agusc4/Realidad-virtual-2022/Codigos/Python/3.jpg

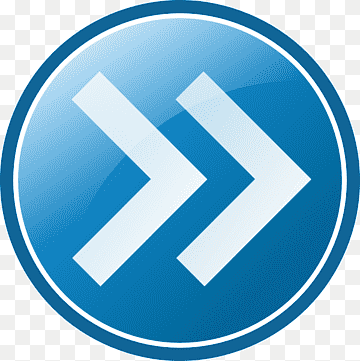
Codigos/Python/3.jpg
