agusc4/Realidad-virtual-2022/README.md

# Realidad-virtual-2022-

Aquí se encuentra el [trabajo final]( https://github.com/agusc4/Realidad-virtual-2022/blob/main/INFORME%20FINAL%20RV.pdf) presentado en la catedra de Realidad Virtual. En el cual se desarrolló un pequeño vehículo diferencial impreso en 3d el cual era controlado a distancia mediante gestos de manos. 

Ademas del informe se encuentran disponibles los [codigos](https://github.com/agusc4/Realidad-virtual-2022/tree/main/Codigos) elavorados en python para el procesamiento de imagenes y asignacion de consignas y en ArduinoID para transmisor, receptor y control de motores.
