agusc4/Realidad-virtual-2022/Codigos/Python/ArUco.pdf

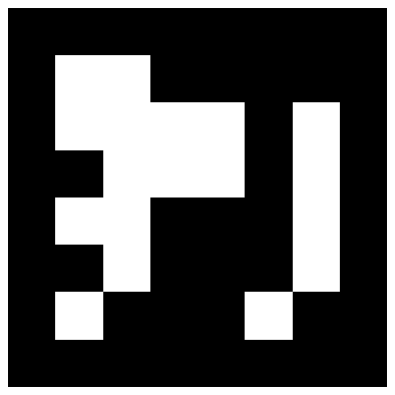
[picture p39: figure]

ID1

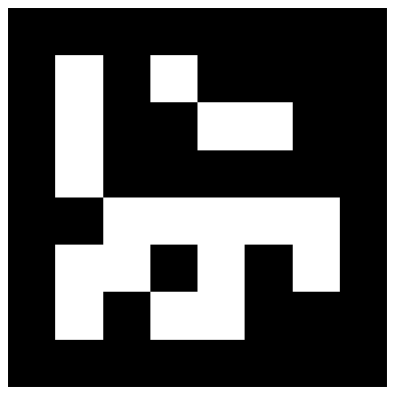
[picture p40: figure]

ID2

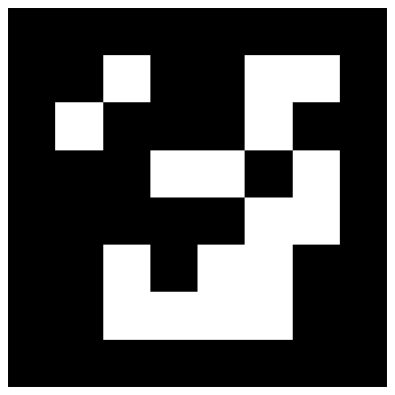
[picture p41: figure]

ID3
