agusc4/Realidad-virtual-2022/Codigos/Python/2.jpg

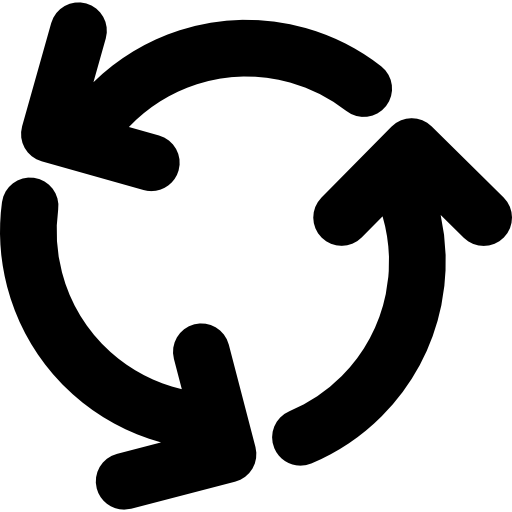
Codigos/Python/2.jpg
